floridan95/arduino_eth_organ/hw/main_board/matrix_scanner.kicad_pcb

## KiCad design hw/main_board/matrix_scanner.kicad_pcb (2020-12-08)

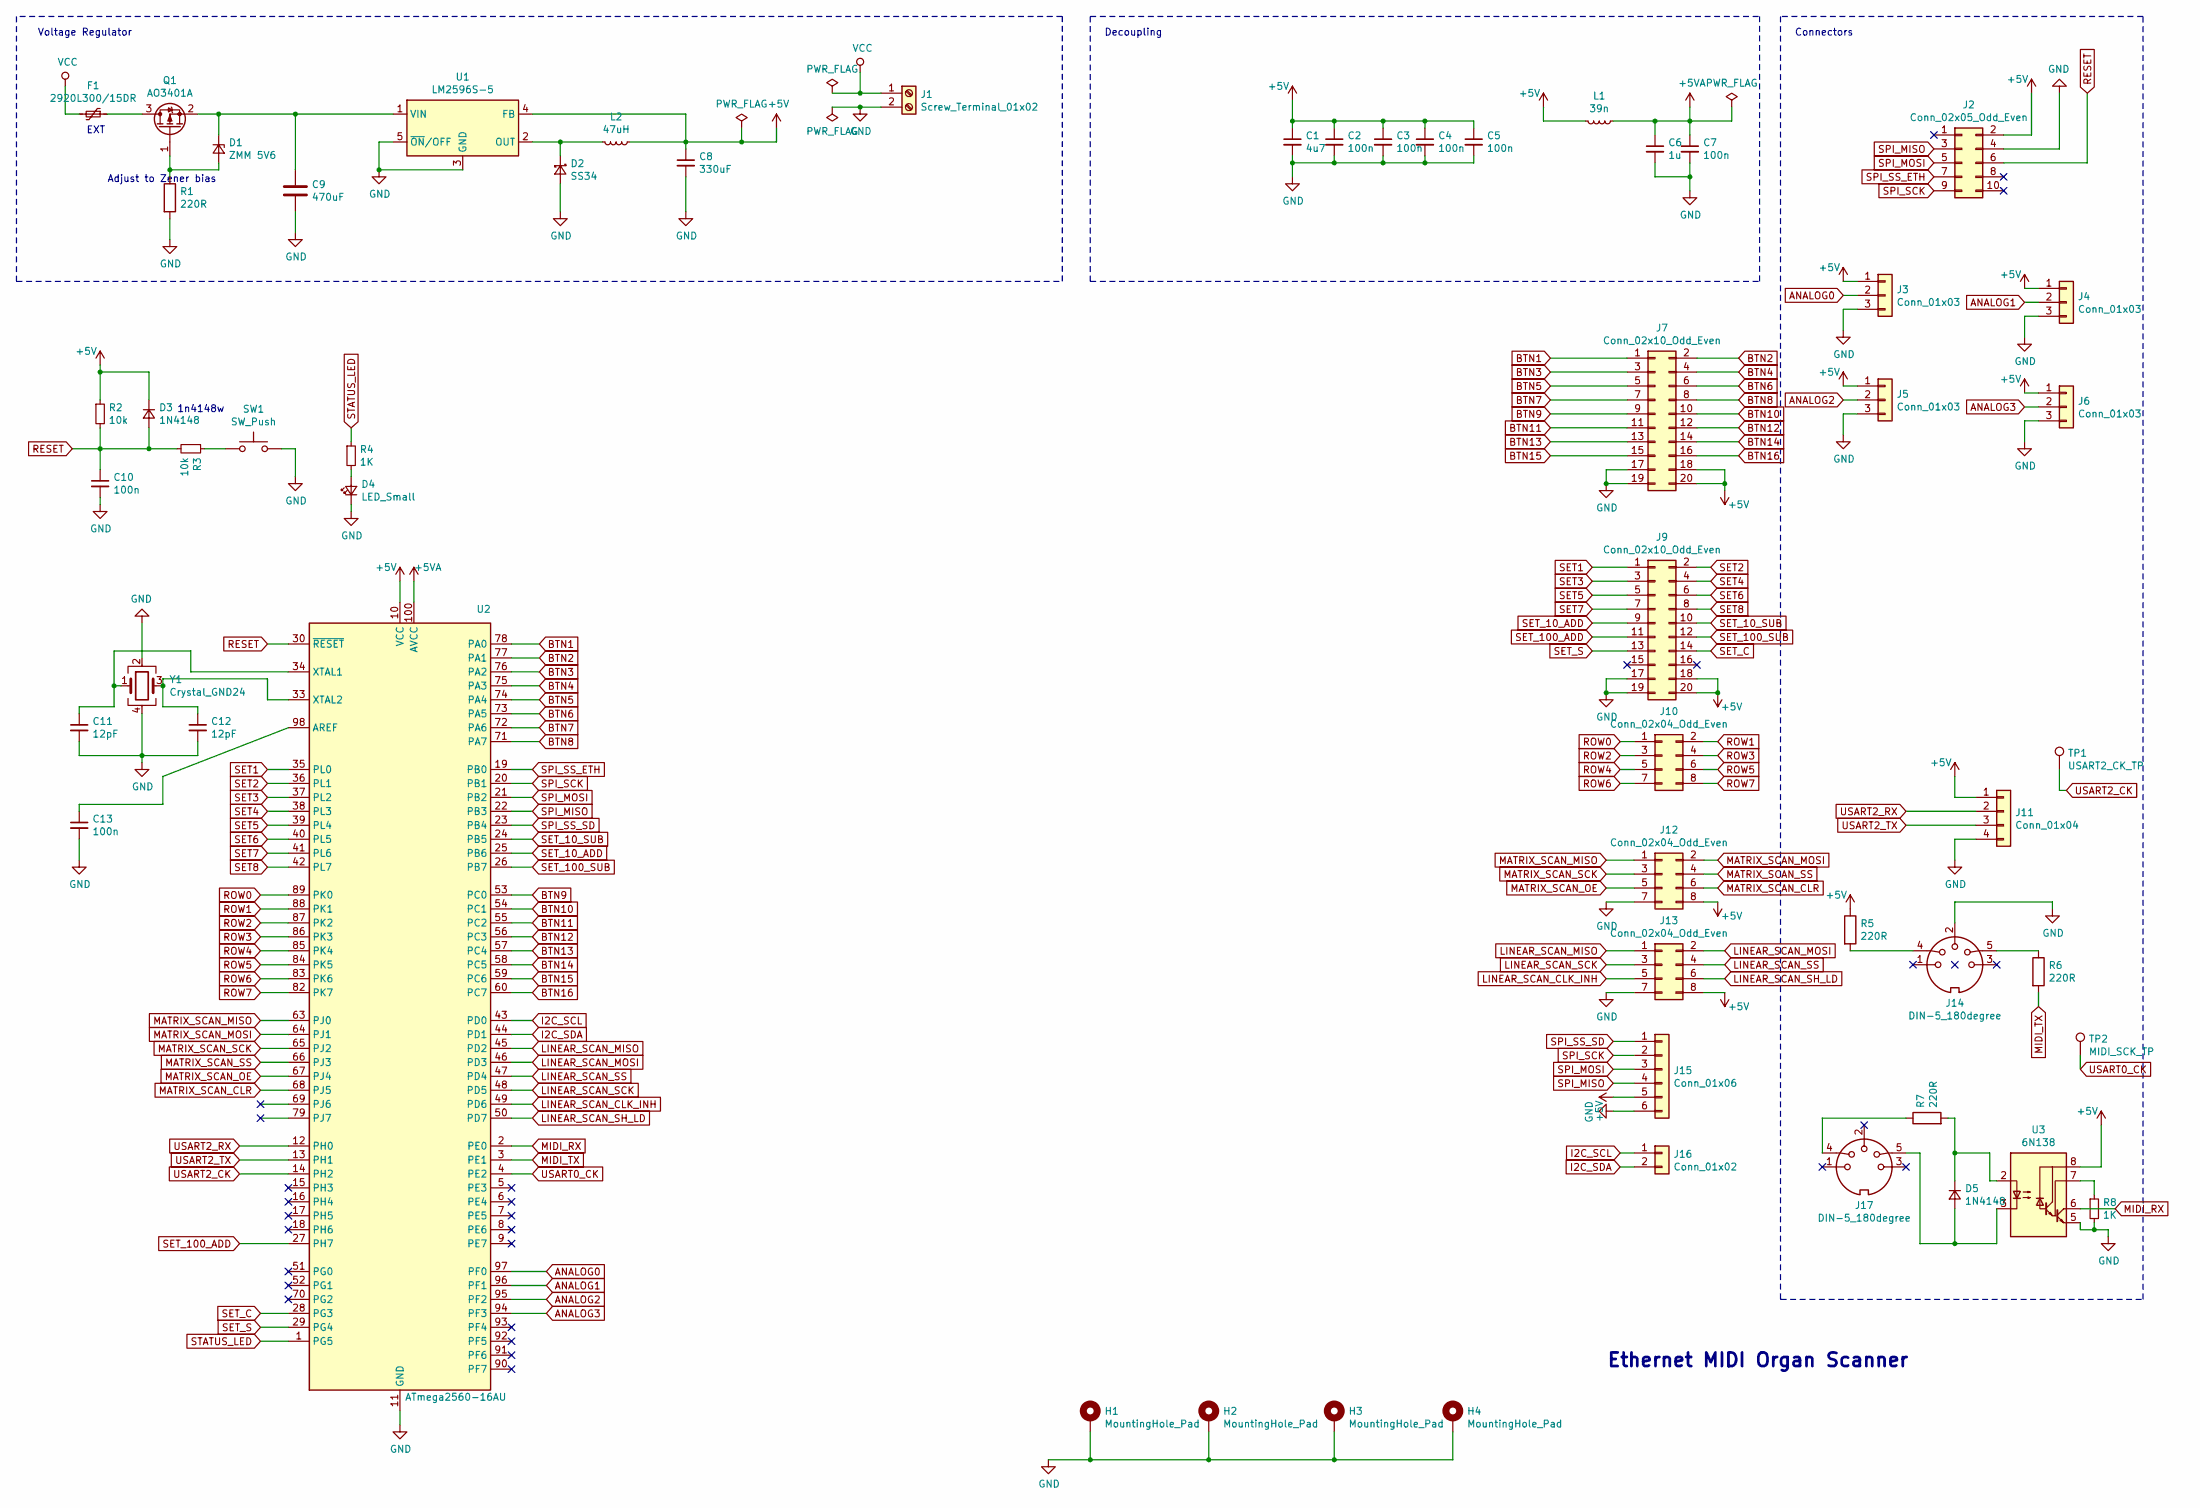
[picture p1: schematic matrix_scanner.sch]

Parts:
C1: 4u7; C_0603_1608Metric_Pad1.05x0.95mm_HandSolder; LCSC C1623
C2, C3, C4, C5, C7, C10, C13: 100n; C_0603_1608Metric_Pad1.05x0.95mm_HandSolder; LCSC C14663
C6: 1u; C_0603_1608Metric_Pad1.05x0.95mm_HandSolder; LCSC C15849
C8: 330uF; CP_Radial_D10.0mm_P5.00mm
C9: 470uF; CP_Radial_D10.0mm_P5.00mm
C11, C12: 12pF; C_0402_1005Metric; LCSC C1547
D1: ZMM 5V6; D_MiniMELF; LCSC C8062
D2: SS34; D_SMA; LCSC C8678
D3, D5: 1N4148; D_SOD-123; LCSC C81598
D4: LED_Small; LED_0603_1608Metric; LCSC C72038
F1: 2920L300/15DR; Fuse_2920_7451Metric; LCSC C207089
H1, H2, H3, H4: MountingHole_Pad; MountingHole_4.3mm_M4_Pad_Via
J1: Screw_Terminal_01x02; TerminalBlock_4Ucon_1x02_P3.50mm_Horizontal
J2: Conn_02x05_Odd_Even; PinSocket_2x05_P2.54mm_Vertical
J3, J4, J5, J6: Conn_01x03; PinSocket_1x03_P2.54mm_Vertical
J7, J9: Conn_02x10_Odd_Even; IDC-Header_2x10_P2.54mm_Vertical_Lock
J10, J12, J13: Conn_02x04_Odd_Even; PinHeader_2x04_P2.54mm_Vertical
J11: Conn_01x04; PinHeader_1x04_P2.54mm_Vertical
J14, J17: DIN-5_180degree; MIDI_DIN5
J15: Conn_01x06; PinHeader_1x06_P2.54mm_Vertical
J16: Conn_01x02; PinHeader_1x02_P2.54mm_Vertical
L1: 39n; L_0402_1005Metric; LCSC C26443
L2: 47uH; L_Bourns_SRR1260; LCSC C115409
Q1: AO3401A; SOT-23; LCSC C15127
R1: 220R; R_1206_3216Metric_Pad1.42x1.75mm_HandSolder; LCSC C17957
R2, R3: 10k; R_0805_2012Metric; LCSC C17414
R4, R8: 1K; R_0805_2012Metric; LCSC C17513
R5, R6, R7: 220R; R_1206_3216Metric; LCSC C17957
SW1: SW_Push; PinHeader_1x02_P2.54mm_Vertical
TP1: USART2_CK_TP; PinHeader_1x01_P2.54mm_Vertical
TP2: MIDI_SCK_TP; PinHeader_1x01_P2.54mm_Vertical
U1: LM2596S-5; TO-263-5_TabPin3; LCSC C10002
U2: ATmega2560-16AU; TQFP-100_14x14mm_P0.5mm; LCSC C22460
U3: 6N138; SMDIP-8_W9.53mm; LCSC C188666
Y1: Crystal_GND24; Crystal_SMD_3225-4Pin_3.2x2.5mm; LCSC C13738

Connections:
+5V: C1.1, C2.1, C3.1, C4.1, C5.1, C8.1, D3.1 (K), J2.2, J3.1, J4.1, J5.1, J6.1, J7.18, J7.20, J9.18, J9.20, J11.1, J12.8, J13.8, J15.5, L1.2, L2.1, R2.1, R5.1, U1.4 (FB), U2.10 (VCC), U2.31 (VCC), U2.61 (VCC), U2.80 (VCC), U3.8 (VCC)
+5VA: C6.1, C7.1, L1.1, U2.100 (AVCC)
ANALOG0: J3.2, U2.97 (PF0)
ANALOG1: J4.2, U2.96 (PF1)
ANALOG2: J5.2, U2.95 (PF2)
ANALOG3: J6.2, U2.94 (PF3)
BTN1: J7.1, U2.78 (PA0)
BTN2: J7.2, U2.77 (PA1)
BTN3: J7.3, U2.76 (PA2)
BTN4: J7.4, U2.75 (PA3)
BTN5: J7.5, U2.74 (PA4)
BTN6: J7.6, U2.73 (PA5)
BTN7: J7.7, U2.72 (PA6)
BTN8: J7.8, U2.71 (PA7)
BTN9: J7.9, U2.53 (PC0)
BTN10: J7.10, U2.54 (PC1)
BTN11: J7.11, U2.55 (PC2)
BTN12: J7.12, U2.56 (PC3)
BTN13: J7.13, U2.57 (PC4)
BTN14: J7.14, U2.58 (PC5)
BTN15: J7.15, U2.59 (PC6)
BTN16: J7.16, U2.60 (PC7)
GND: C1.2, C2.2, C3.2, C4.2, C5.2, C6.2, C7.2, C8.2, C9.2, C10.2, C11.2, C12.2, C13.2, D2.2 (A), D4.1 (K), H1.1, H2.1, H3.1, H4.1, J1.2, J2.4, J3.3, J4.3, J5.3, J6.3, J7.17, J7.19, J9.17, J9.19, J11.4, J12.7, J13.7, J14.2, J15.6, R1.2, R8.2, SW1.2, U1.3 (GND), U1.5 (~ON~/OFF), U2.11 (GND), U2.32 (GND), U2.62 (GND), U2.81 (GND), U2.99 (GND), U3.5 (GND), Y1.2, Y1.4
I2C_SCL: J16.1, U2.43 (PD0)
I2C_SDA: J16.2, U2.44 (PD1)
LINEAR_SCAN_CLK_INH: J13.5, U2.49 (PD6)
LINEAR_SCAN_MISO: J13.1, U2.45 (PD2)
LINEAR_SCAN_MOSI: J13.2, U2.46 (PD3)
LINEAR_SCAN_SCK: J13.3, U2.48 (PD5)
LINEAR_SCAN_SH_LD: J13.6, U2.50 (PD7)
LINEAR_SCAN_SS: J13.4, U2.47 (PD4)
MATRIX_SCAN_CLR: J12.6, U2.68 (PJ5)
MATRIX_SCAN_MISO: J12.1, U2.63 (PJ0)
MATRIX_SCAN_MOSI: J12.2, U2.64 (PJ1)
MATRIX_SCAN_OE: J12.5, U2.67 (PJ4)
MATRIX_SCAN_SCK: J12.3, U2.65 (PJ2)
MATRIX_SCAN_SS: J12.4, U2.66 (PJ3)
MIDI_RX: U2.2 (PE0), U3.6 (VO2)
MIDI_TX: R6.2, U2.3 (PE1)
unnamed: C9.1, D1.1 (K), Q1.2 (S), U1.1 (VIN)
unnamed: C11.1, U2.34 (XTAL1), Y1.1
unnamed: C12.1, U2.33 (XTAL2), Y1.3
unnamed: C13.1, U2.98 (AREF)
unnamed: D1.2 (A), Q1.1 (G), R1.1
unnamed: D2.1 (K), L2.2, U1.2 (OUT)
unnamed: D4.2 (A), R4.2
unnamed: D5.1 (K), R7.2, U3.2 (C1)
unnamed: D5.2 (A), J17.5, U3.3 (C2)
unnamed: F1.1, Q1.3 (D)
unnamed: J14.4, R5.2
unnamed: J14.5, R6.1
unnamed: J17.4, R7.1
unnamed: R3.1, SW1.1
unnamed: R8.1, U3.7 (VO1)
RESET: C10.1, D3.2 (A), J2.6, R2.2, R3.2, U2.30 (~RESET)
ROW0: J10.1, U2.89 (PK0)
ROW1: J10.2, U2.88 (PK1)
ROW2: J10.3, U2.87 (PK2)
ROW3: J10.4, U2.86 (PK3)
ROW4: J10.5, U2.85 (PK4)
ROW5: J10.6, U2.84 (PK5)
ROW6: J10.7, U2.83 (PK6)
ROW7: J10.8, U2.82 (PK7)
SET1: J9.1, U2.35 (PL0)
SET2: J9.2, U2.36 (PL1)
SET3: J9.3, U2.37 (PL2)
SET4: J9.4, U2.38 (PL3)
SET5: J9.5, U2.39 (PL4)
SET6: J9.6, U2.40 (PL5)
SET7: J9.7, U2.41 (PL6)
SET8: J9.8, U2.42 (PL7)
SET_10_ADD: J9.9, U2.25 (PB6)
SET_10_SUB: J9.10, U2.24 (PB5)
SET_100_ADD: J9.11, U2.27 (PH7)
SET_100_SUB: J9.12, U2.26 (PB7)
SET_C: J9.14, U2.28 (PG3)
SET_S: J9.13, U2.29 (PG4)
SPI_MISO: J2.3, J15.4, U2.22 (PB3)
SPI_MOSI: J2.5, J15.3, U2.21 (PB2)
SPI_SCK: J2.9, J15.2, U2.20 (PB1)
SPI_SS_ETH: J2.7, U2.19 (PB0)
SPI_SS_SD: J15.1, U2.23 (PB4)
STATUS_LED: R4.1, U2.1 (PG5)
USART0_CK: TP2.1, U2.4 (PE2)
USART2_CK: TP1.1, U2.14 (PH2)
USART2_RX: J11.2, U2.12 (PH0)
USART2_TX: J11.3, U2.13 (PH1)
VCC: F1.2, J1.1

Notes on the sheet:
1n4148w
Adjust to Zener bias
Voltage Regulator
Decoupling
Connectors
Ethernet MIDI Organ Scanner
EXT

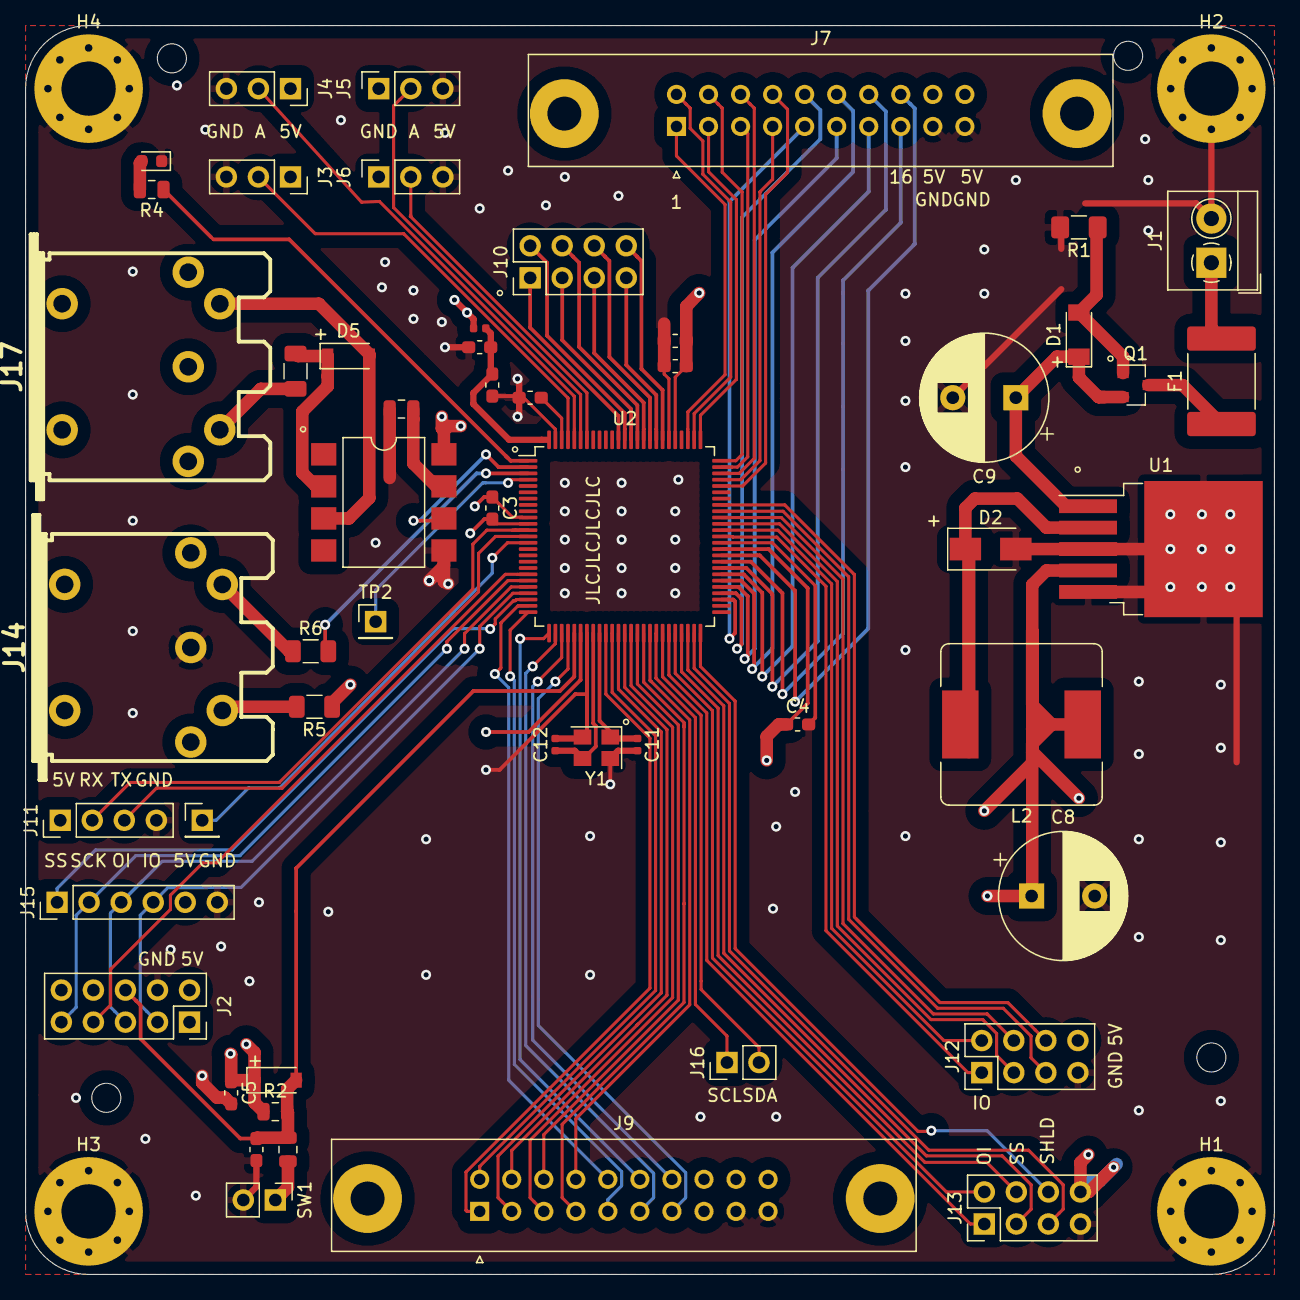
[picture p2: board matrix_scanner.kicad_pcb from above]

Board: 4 copper layers, 99.0 x 99.0 mm, 57 parts (0 on the bottom side), 88 nets.
