floridan95/arduino_eth_organ/hw/output_driver/output_driver.kicad_pcb

## KiCad design hw/output_driver/output_driver.kicad_pcb (2020-12-08)

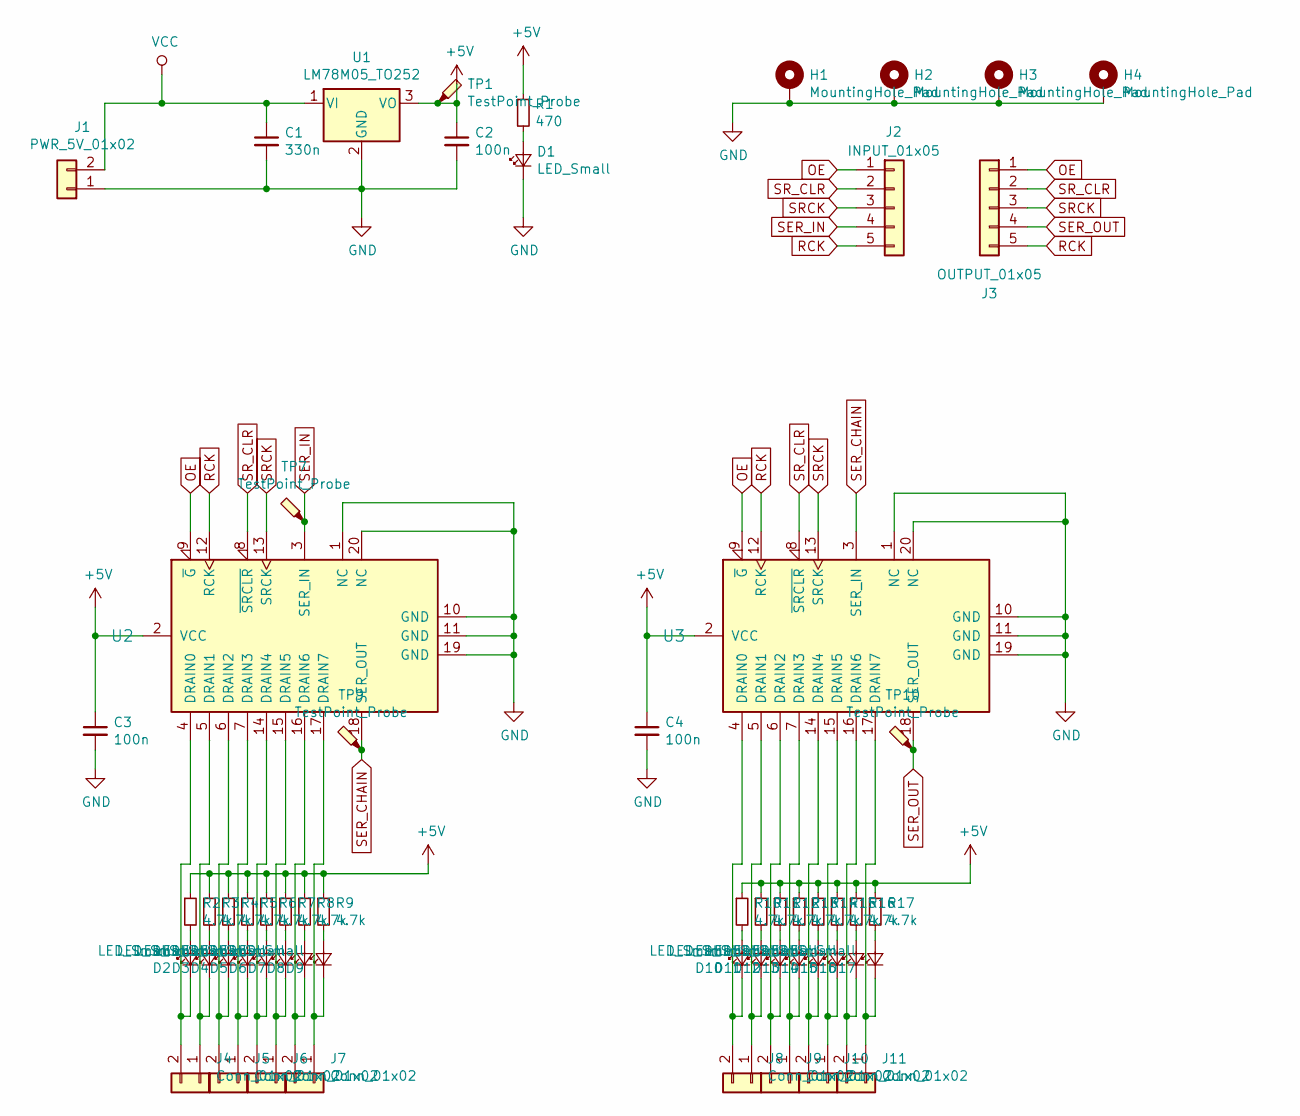
[picture p3: schematic output_driver.sch]

Parts:
C1: 330n; C_0805_2012Metric_Pad1.15x1.40mm_HandSolder; LCSC C1740
C2, C3, C4: 100n; C_0805_2012Metric_Pad1.15x1.40mm_HandSolder; JLCPCB C24497
D1, D2, D3, D4, D5, D6, D7, D8, D9, D10, D11, D12, D13, D14, D15, D16, D17: LED_Small; LED_0805_2012Metric_Pad1.15x1.40mm_HandSolder; JLCPCB C2296
H1, H2, H3, H4: MountingHole_Pad; MountingHole_4.3mm_M4_Pad_Via
J1: PWR_5V_01x02; TerminalBlock_4Ucon_1x02_P3.50mm_Horizontal
J2: INPUT_01x05; PinHeader_1x05_P2.54mm_Vertical
J3: OUTPUT_01x05; PinHeader_1x05_P2.54mm_Vertical
J4, J5, J6, J7, J8, J9, J10, J11: Conn_01x02; PinHeader_1x02_P2.54mm_Vertical
R1: 470; R_0805_2012Metric_Pad1.15x1.40mm_HandSolder; JLCPCB C17710
R2, R3, R4, R5, R6, R7, R8, R9, R10, R11, R12, R13, R14, R15, R16, R17: 4.7k; R_0805_2012Metric_Pad1.15x1.40mm_HandSolder; JLCPCB C17673
TP1, TP7, TP9, TP10: TestPoint_Probe; TestPoint_Pad_D2.5mm
U1: LM78M05_TO252; TO-252-2; JLCPCB C58069
U2, U3: TPIC6B595N; SOIC-20W_7.5x12.8mm_P1.27mm; JLCPCB C7094

Connections:
+5V: C2.1, C3.1, C4.1, R1.1, R2.1, R3.1, R4.1, R5.1, R6.1, R7.1, R8.1, R9.1, R10.1, R11.1, R12.1, R13.1, R14.1, R15.1, R16.1, R17.1, TP1.1, U1.3 (VO), U2.2 (VCC), U3.2 (VCC)
GND: C1.2, C2.2, C3.2, C4.2, D1.1 (K), H1.1, H2.1, H3.1, H4.1, J1.1, U1.2 (GND), U2.1 (NC), U2.10 (GND), U2.11 (GND), U2.19 (GND), U2.20 (NC), U3.1 (NC), U3.10 (GND), U3.11 (GND), U3.19 (GND), U3.20 (NC)
unnamed: D1.2 (A), R1.2
unnamed: D2.1 (K), J4.2, U2.4 (DRAIN0)
unnamed: D2.2 (A), R2.2
unnamed: D3.1 (K), J4.1, U2.5 (DRAIN1)
unnamed: D3.2 (A), R3.2
unnamed: D4.1 (K), J5.2, U2.6 (DRAIN2)
unnamed: D4.2 (A), R4.2
unnamed: D5.1 (K), J5.1, U2.7 (DRAIN3)
unnamed: D5.2 (A), R5.2
unnamed: D6.1 (K), J6.2, U2.14 (DRAIN4)
unnamed: D6.2 (A), R6.2
unnamed: D7.1 (K), J6.1, U2.15 (DRAIN5)
unnamed: D7.2 (A), R7.2
unnamed: D8.1 (K), J7.2, U2.16 (DRAIN6)
unnamed: D8.2 (A), R8.2
unnamed: D9.1 (K), J7.1, U2.17 (DRAIN7)
unnamed: D9.2 (A), R9.2
unnamed: D10.1 (K), J8.2, U3.4 (DRAIN0)
unnamed: D10.2 (A), R10.2
unnamed: D11.1 (K), J8.1, U3.5 (DRAIN1)
unnamed: D11.2 (A), R11.2
unnamed: D12.1 (K), J9.2, U3.6 (DRAIN2)
unnamed: D12.2 (A), R12.2
unnamed: D13.1 (K), J9.1, U3.7 (DRAIN3)
unnamed: D13.2 (A), R13.2
unnamed: D14.1 (K), J10.2, U3.14 (DRAIN4)
unnamed: D14.2 (A), R14.2
unnamed: D15.1 (K), J10.1, U3.15 (DRAIN5)
unnamed: D15.2 (A), R15.2
unnamed: D16.1 (K), J11.2, U3.16 (DRAIN6)
unnamed: D16.2 (A), R16.2
unnamed: D17.1 (K), J11.1, U3.17 (DRAIN7)
unnamed: D17.2 (A), R17.2
OE: J2.1, J3.1, U2.9 (~G), U3.9 (~G)
RCK: J2.5, J3.5, U2.12 (RCK), U3.12 (RCK)
SER_CHAIN: TP9.1, U2.18 (SER_OUT), U3.3 (SER_IN)
SER_IN: J2.4, TP7.1, U2.3 (SER_IN)
SER_OUT: J3.4, TP10.1, U3.18 (SER_OUT)
SRCK: J2.3, J3.3, U2.13 (SRCK), U3.13 (SRCK)
SR_CLR: J2.2, J3.2, U2.8 (~SRCLR), U3.8 (~SRCLR)
VCC: C1.1, J1.2, U1.1 (VI)

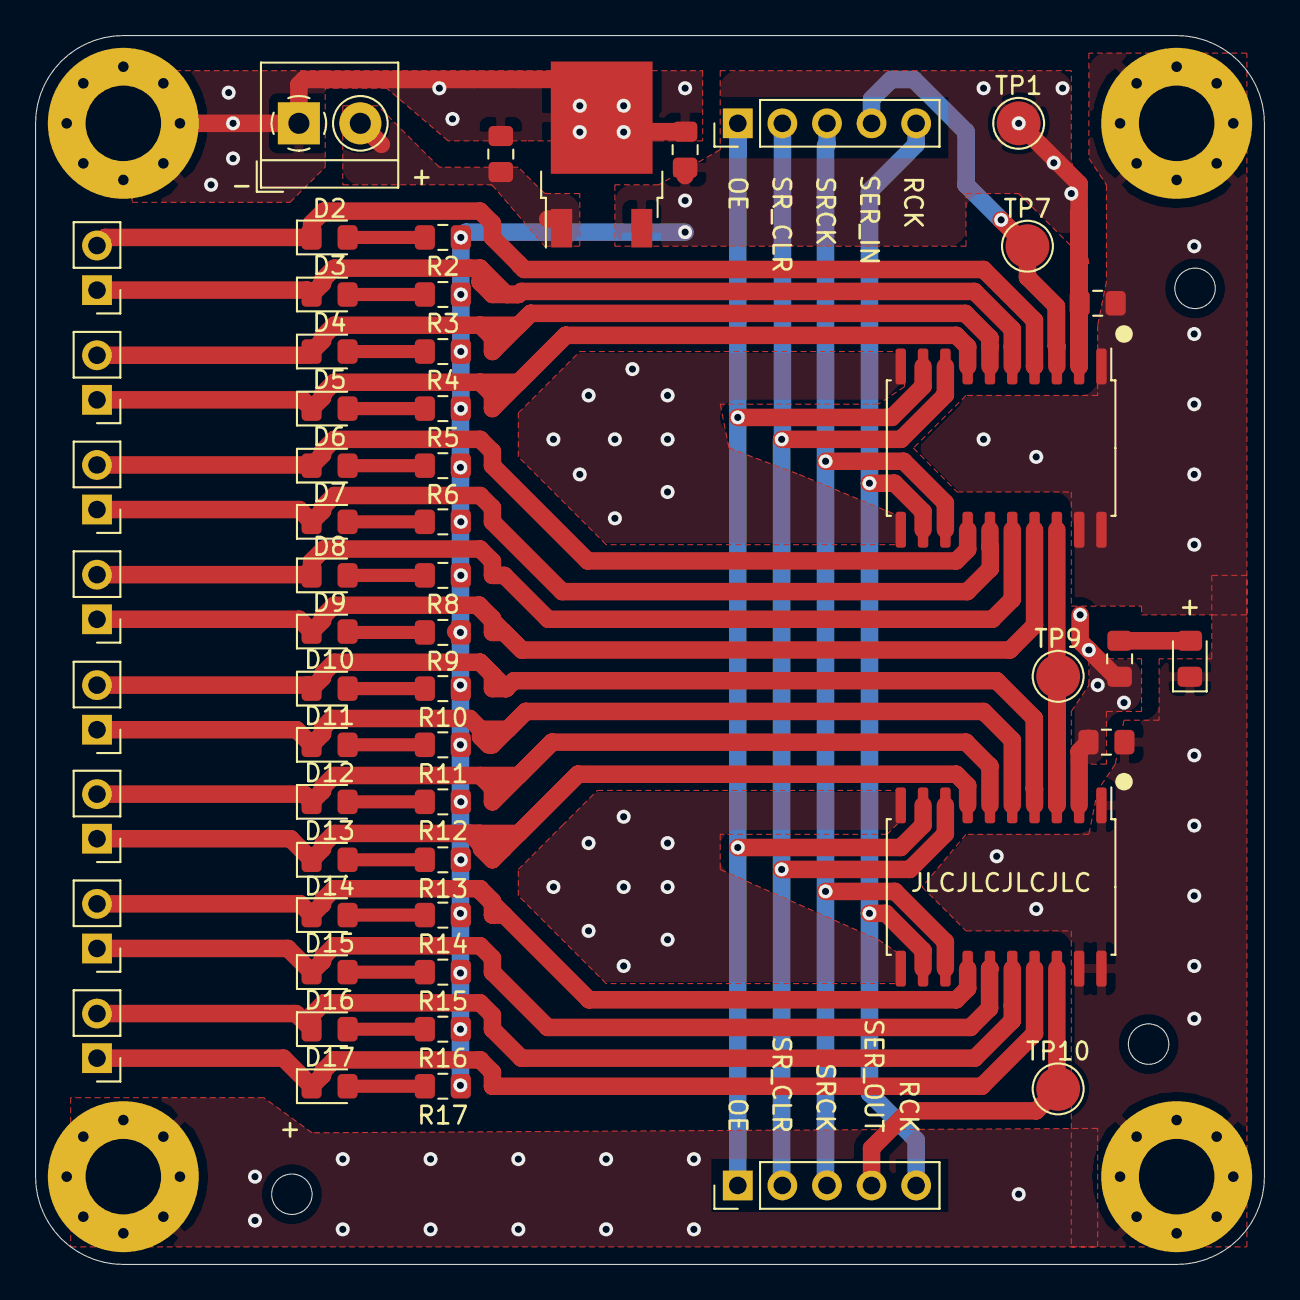
[picture p4: board output_driver.kicad_pcb from above]

Board: 2 copper layers, 70.0 x 70.0 mm, 60 parts (0 on the bottom side), 43 nets.
