floridan95/arduino_eth_organ/(commit log)

2020-12-08 Add hardware files
    [matrix_scanner-B_Cu.gbr, matrix_scanner-B_Mask.gbr, matrix_scanner-B_SilkS.gbr, matrix_scanner-Edge_Cuts.gbr, matrix_scanner-F_Cu.gbr, matrix_scanner-F_Mask.gbr, matrix_scanner-F_SilkS.gbr, matrix_scanner-In1_Cu.gbr]
2020-12-14 Couplers initial impl
